AxelOrdi/Damier/DOC/7127br5-NyL._AC_SL1500_.jpg

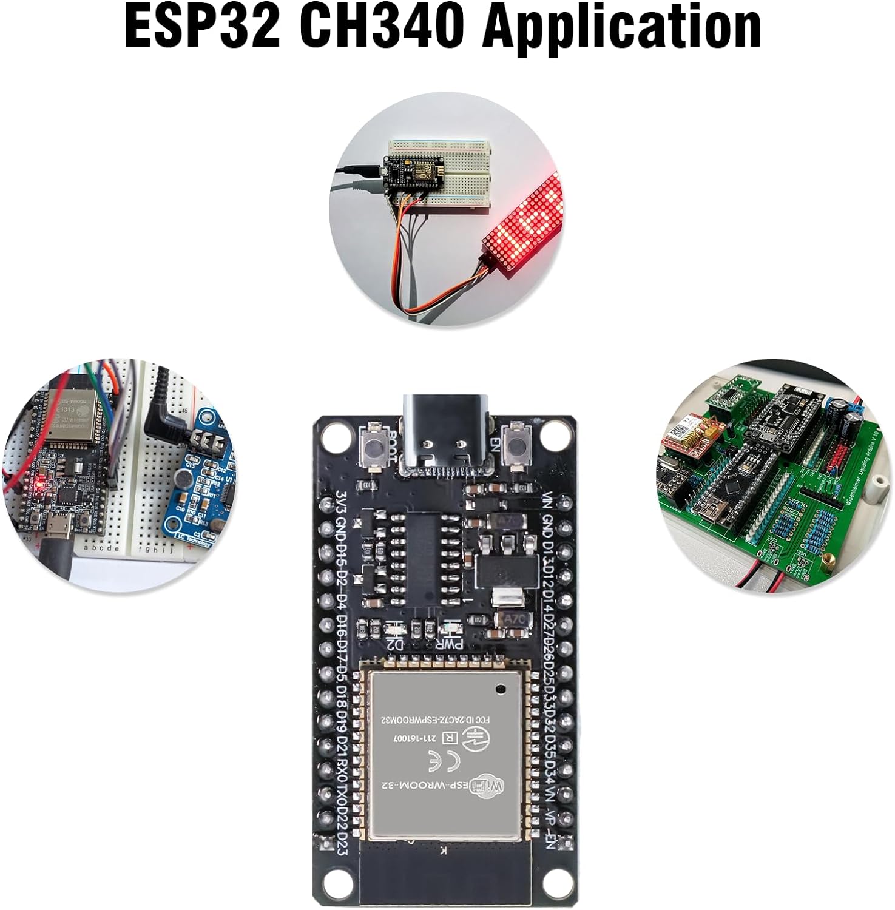
DOC/7127br5-NyL._AC_SL1500_.jpg
