AxelOrdi/Damier/Compte Rendu/CR/Diagramme de classe damier.drawio.pdf

Pion

- uint32_t couleur_led
- bool Reine
- bool PionBlanc

+ Pion()

+void setReine();

+bool getReine();

+uint32_t get_Couleur_led()

+void set_Couleur_led(uint32_t)

+void set_PionBlanc(bool pb)

+bool get_PionBlanc()

Pion_Blanc

+static int NbPionBlanc

Pion_Noir

+static int NbPionNoir

| Plateau
- Case Tableau[][] + void Initialisation_tableau() +void Commencer_Partie() + void Set_Couleur_Tableau_sans_Pion()

+ Case get_CasePlateau(int ligne,int colonne)

Case

- uint32_t couleur_led
- bool pion_sur_case
- bool case_blanche
- int num_case_strip
- int colonne
- int ligne
- Pion* Case

+ Case()

+ Case(uint32_t c , bool etat)

+ uint32_t get_couleur_led()

+ void set_couleur_led(Adafruit_NeoPixel STRIP_LED, uint32_t couleur_led)

+ bool get_pion_sur_case()

+ void set_pion_sur_case(bool b)

+ bool get_case_blanche()

+ void set_case_blanche(bool b)

+ void set_ligne(int ligne)

+ int get_ligne()

+ void set_colonne(int colonne)

+ int get_colonne()

+ void set_coordonnees(int ligne, int colonne)

+ vector<int> get_coordonnees()

+ Pion* get_Pion_case()

+ void set_Pion_case(Pion* p)

+ void Change_Couleur_Fct_Pion()

1

100

0..1 | 1

Jeu_de_Dame

//- Plateau Plateau_Jeu

- bool tour

+ Jeu_de_Dame()

+ void Initialisation_Pion()

+ void Commencer_Partie_Jeu_De_Dame ()

+ int Deplacer_Pion(std :: vector<int> Vecteur_Coordonnee_Initiale, std :: vector<int> Vecteur_Coordonnee_Finale)

+ int Verif_Deplacement_Possible(bool couleurTour, int ligneDepart, int colonneDepart, int ligneArrivee, int colonneArrivee)

+ int Manger_Pion(int Ligne_Position_Initiale,int Colonne_Position_initiale,int Ligne_Position_Finale,int Colonne_Position_Finale)

+ int Verif_Deplacement_Manger_Pion(int Ligne_Position,int Colonne_Position)

+ void Deroulement_Tour()

+ int Verif_Couleur_Pion(std ::vector<int> Vecteur_Coordonnee_Initiale)

+ int Etat_Attente_1(std::vector <int> &Vecteur_Coordonnee_Initiale)

+ int Etat_Attente_2(std ::vector<int> &Vecteur_Coordonnee_Initiale)

+ void Fin_de_jeu();

1

1
