AxelOrdi/Damier/3D/Paint_Damier.png

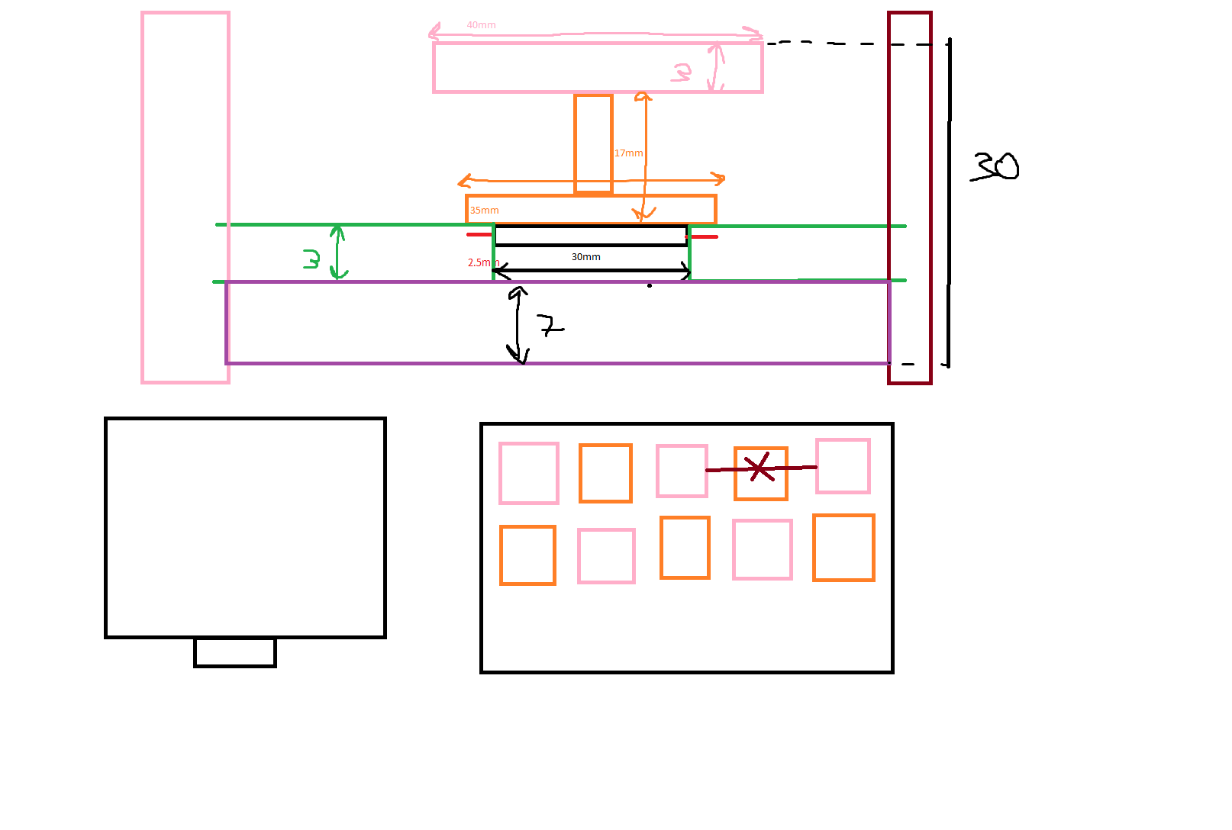
3D/Paint_Damier.png
