AxelOrdi/Damier/DOC/ESP32-DOIT-DEVKIT-V1-Board-Pinout-30-GPIOs-Copy.png

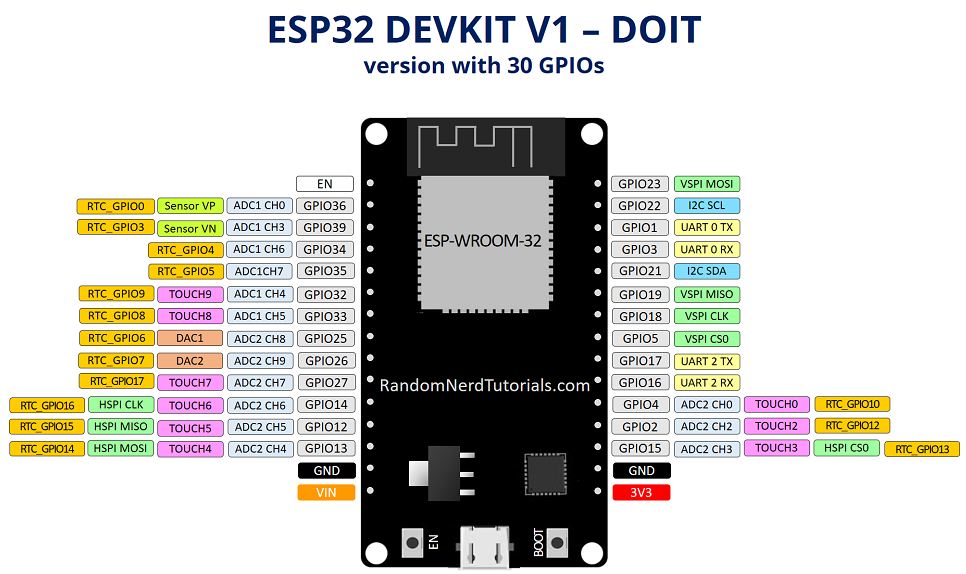
DOC/ESP32-DOIT-DEVKIT-V1-Board-Pinout-30-GPIOs-Copy.png
