AxelOrdi/Damier/3D/box_back.dxf

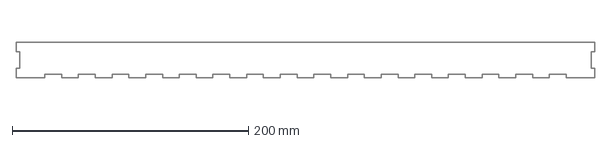
[picture p8: CAD file, 2023-12-12]
3D/box_back.dxf
490.0 x 30.0 mm
