AxelOrdi/Damier/3D/box_right.dxf

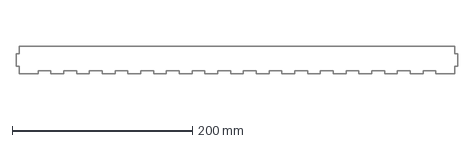
[picture p9: CAD file, 2023-12-12]
3D/box_right.dxf
490.0 x 30.0 mm
