AxelOrdi/Damier/3D/box_left.dxf

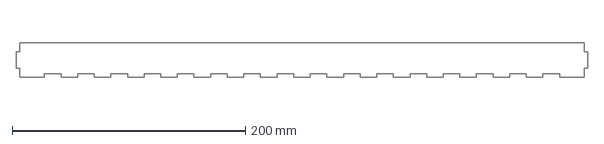
[picture p10: CAD file, 2023-12-12]
3D/box_left.dxf
490.0 x 30.0 mm
