AxelOrdi/Damier/3D/box_bottom.dxf

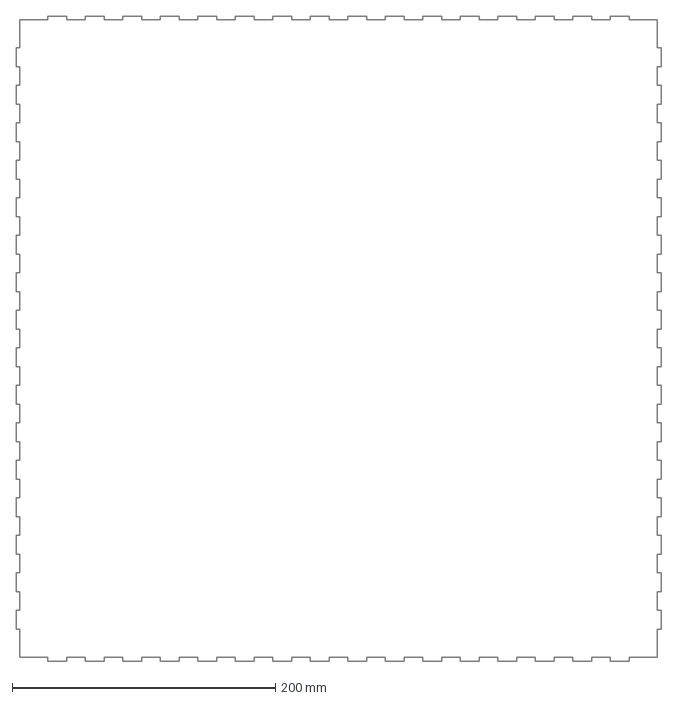
[picture p11: CAD file, 2023-12-12]
3D/box_bottom.dxf
490.0 x 490.0 mm
