AxelOrdi/Damier/3D/box_front.dxf

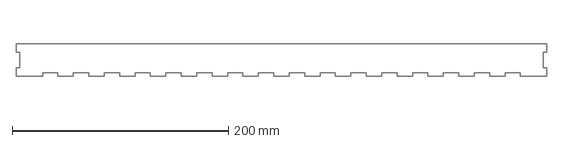
[picture p12: CAD file, 2023-12-12]
3D/box_front.dxf
490.0 x 30.0 mm
