AxelOrdi/Damier/PCB SLAVE/Le_damier.kicad_pcb

## KiCad design PCB SLAVE/Le_damier.kicad_pcb (2023-12-12)

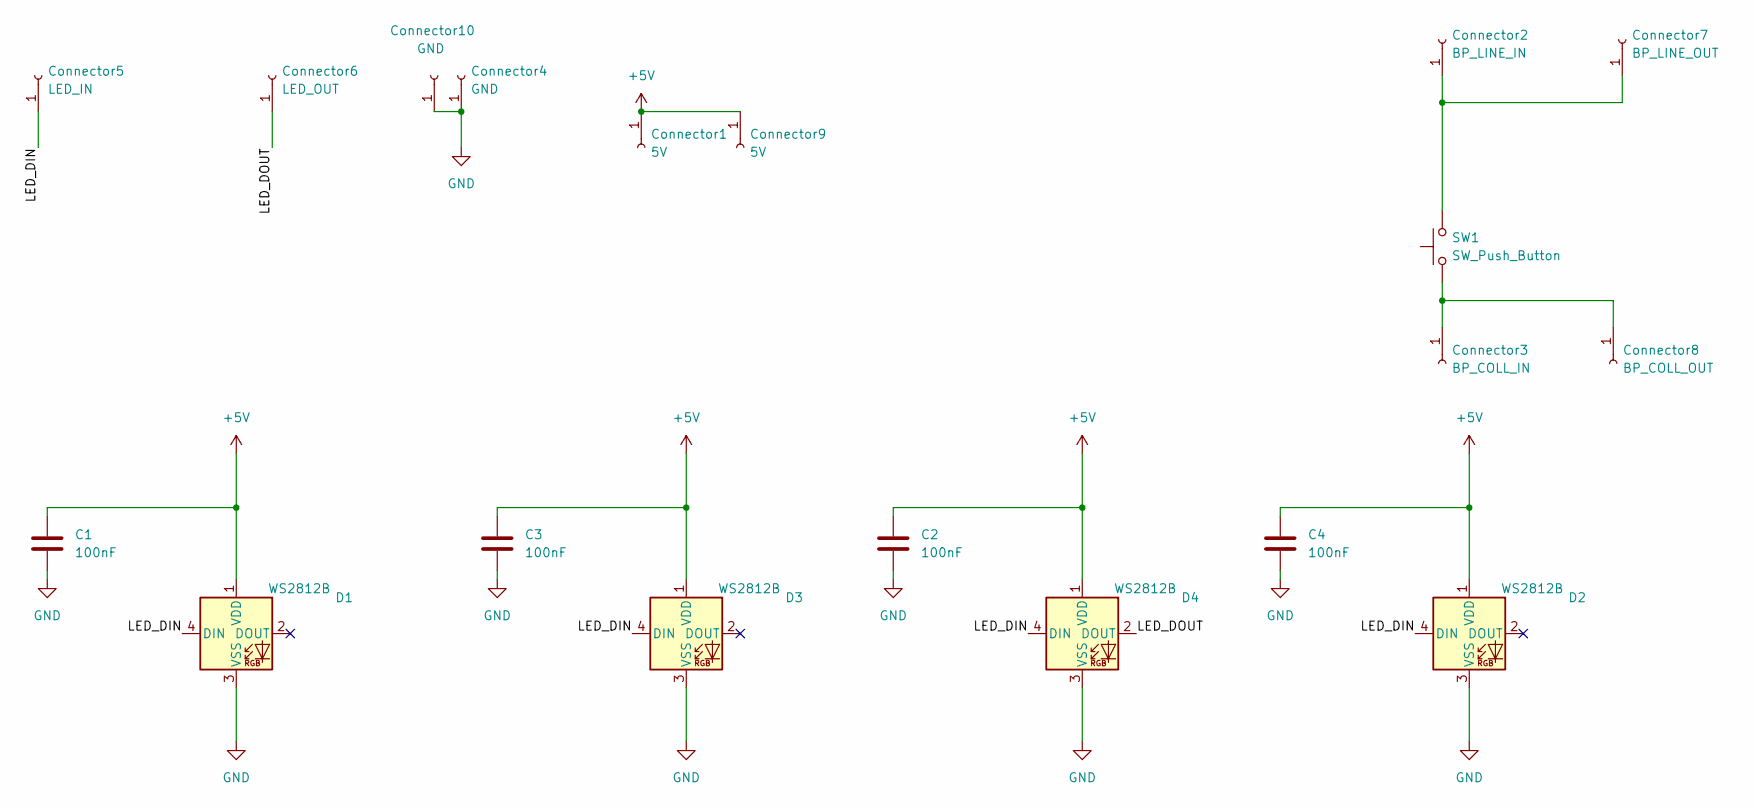
[picture p13: schematic Le_damier.kicad_sch]

Parts:
C1, C2, C3, C4: 100nF; C_1206_3216Metric
Connector1, Connector9: 5V; PinHeader_1x01_P2.54mm_Vertical
Connector2: BP_LINE_IN; PinHeader_1x01_P2.54mm_Vertical
Connector3: BP_COLL_IN; PinHeader_1x01_P2.54mm_Vertical
Connector4, Connector10: GND; PinHeader_1x01_P2.54mm_Vertical
Connector5: LED_IN; PinHeader_1x01_P2.54mm_Vertical
Connector6: LED_OUT; PinHeader_1x01_P2.54mm_Vertical
Connector7: BP_LINE_OUT; PinHeader_1x01_P2.54mm_Vertical
Connector8: BP_COLL_OUT; PinHeader_1x01_P2.54mm_Vertical
D1, D2, D3, D4: WS2812B; LED_WS2812B_PLCC4_5.0x5.0mm_P3.2mm
SW1: SW_Push_Button; SW_PUSH_6mm

Connections:
+5V: C1.1, C2.1, C3.1, C4.1, Connector1.1, Connector9.1, D1.1 (VDD), D2.1 (VDD), D3.1 (VDD), D4.1 (VDD)
/LED_DIN: Connector5.1, D1.4 (DIN), D2.4 (DIN), D3.4 (DIN), D4.4 (DIN)
/LED_DOUT: Connector6.1, D4.2 (DOUT)
GND: C1.2, C2.2, C3.2, C4.2, Connector4.1, Connector10.1, D1.3 (VSS), D2.3 (VSS), D3.3 (VSS), D4.3 (VSS)
unnamed: Connector2.1, Connector7.1, SW1.2
unnamed: Connector3.1, Connector8.1, SW1.1

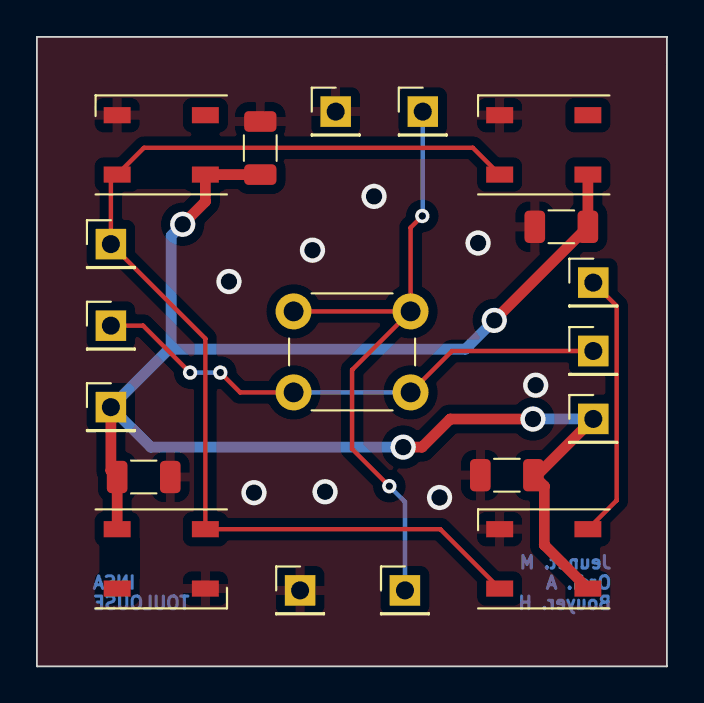
[picture p14: board Le_damier.kicad_pcb from above]

Board: 2 copper layers, 35.0 x 35.0 mm, 19 parts (0 on the bottom side), 6 nets.
