AxelOrdi/Damier/PCB MAITRE/MAIN v2/MAIN.kicad_pcb

## KiCad design PCB MAITRE/MAIN v2/MAIN.kicad_pcb (2023-12-12)

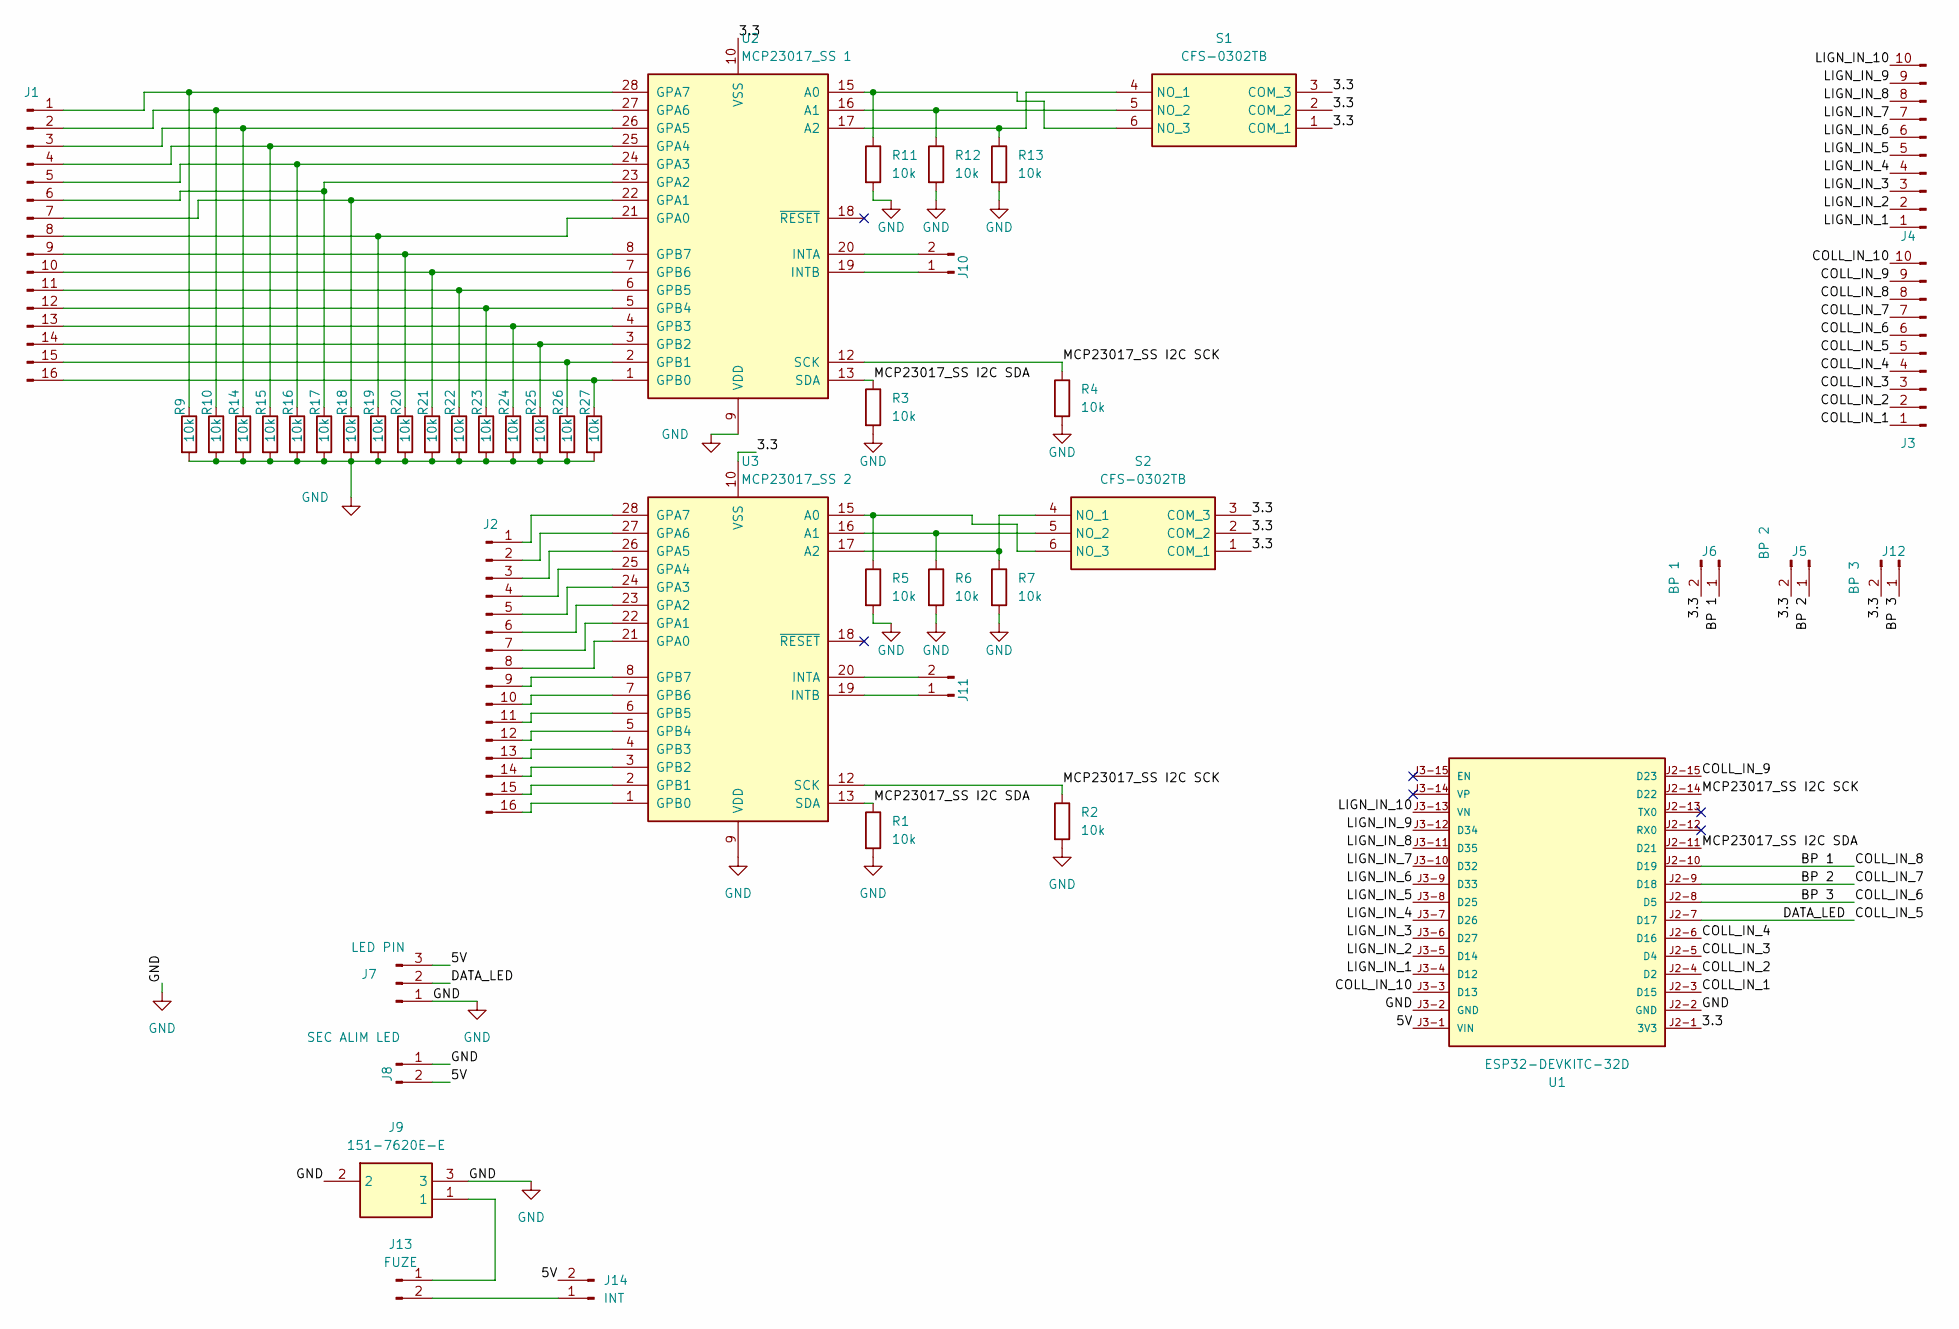
[picture p15: schematic MAIN.kicad_sch]

Parts:
J1, J2: Conn_01x16_Pin; PinHeader_1x16_P2.54mm_Vertical
J3, J4: Conn_01x10_Pin; PinHeader_1x10_P2.54mm_Vertical
J5: BP 2; PinHeader_1x02_P2.54mm_Vertical
J6: BP 1; PinHeader_1x02_P2.54mm_Vertical
J7: LED PIN; SolderWire-2.5sqmm_1x03_P8.8mm_D2.4mm_OD4.4mm
J8: SEC ALIM LED; SolderWire-2.5sqmm_1x02_P8.8mm_D2.4mm_OD4.4mm
J9: 151-7620E-E; 1517620EE; Mouser Part Number 151-7620E-E
J10: INTAB MCP23017 1; PinHeader_1x02_P2.54mm_Vertical
J11: INTAB MCP23017 2; PinHeader_1x02_P2.54mm_Vertical
J12: BP 3; PinHeader_1x02_P2.54mm_Vertical
J13: FUZE; SolderWire-2.5sqmm_1x02_P8.8mm_D2.4mm_OD4.4mm
J14: INT; SolderWire-2.5sqmm_1x02_P8.8mm_D2.4mm_OD4.4mm
R1, R2, R3, R4, R5, R6, R7, R9, R10, R11, R12, R13, R14, R15, R16, R17, R18, R19, R20, R21, R22, R23, R24, R25, R26, R27: 10k; R_1206_3216Metric
S1, S2: CFS-0302TB; CFS0302TB; Mouser Part Number 229-CFS-0302TB
U1: ESP32-DEVKITC-32D; MODULE_ESP32-DEVKITC-32D; PARTREV V4
U2: MCP23017_SS 1; SSOP-28_5.3x10.2mm_P0.65mm
U3: MCP23017_SS 2; SSOP-28_5.3x10.2mm_P0.65mm

Connections:
/3.3: J5.2, J6.2, J12.2, S1.1 (COM_1), S1.2 (COM_2), S1.3 (COM_3), S2.1 (COM_1), S2.2 (COM_2), S2.3 (COM_3), U1.J2-1 (3V3), U2.10 (VSS), U3.10 (VSS)
/5V: J7.3, J8.2, J14.2, U1.J3-1 (VIN)
/BP 1: J3.8, J6.1, U1.J2-10 (D19)
/BP 2: J3.7, J5.1, U1.J2-9 (D18)
/BP 3: J3.6, J12.1, U1.J2-8 (D5)
/COLL_IN_1: J3.1, U1.J2-3 (D15)
/COLL_IN_2: J3.2, U1.J2-4 (D2)
/COLL_IN_3: J3.3, U1.J2-5 (D4)
/COLL_IN_4: J3.4, U1.J2-6 (D16)
/COLL_IN_5: J3.5, J7.2, U1.J2-7 (D17)
/COLL_IN_9: J3.9, U1.J2-15 (D23)
/COLL_IN_10: J3.10, U1.J3-3 (D13)
/LIGN_IN_1: J4.1, U1.J3-4 (D12)
/LIGN_IN_2: J4.2, U1.J3-5 (D14)
/LIGN_IN_3: J4.3, U1.J3-6 (D27)
/LIGN_IN_4: J4.4, U1.J3-7 (D26)
/LIGN_IN_5: J4.5, U1.J3-8 (D25)
/LIGN_IN_6: J4.6, U1.J3-9 (D33)
/LIGN_IN_7: J4.7, U1.J3-10 (D32)
/LIGN_IN_8: J4.8, U1.J3-11 (D35)
/LIGN_IN_9: J4.9, U1.J3-12 (D34)
/LIGN_IN_10: J4.10, U1.J3-13 (VN)
/MCP23017_SS I2C SCK: R2.1, R4.1, U1.J2-14 (D22), U2.12 (SCK), U3.12 (SCK)
/MCP23017_SS I2C SDA: R1.1, R3.1, U1.J2-11 (D21), U2.13 (SDA), U3.13 (SDA)
GND: J7.1, J8.1, J9.2, J9.3, R1.2, R2.2, R3.2, R4.2, R5.2, R6.2, R7.2, R9.2, R10.2, R11.2, R12.2, R13.2, R14.2, R15.2, R16.2, R17.2, R18.2, R19.2, R20.2, R21.2, R22.2, R23.2, R24.2, R25.2, R26.2, R27.2, U1.J2-2 (GND), U1.J3-2 (GND), U2.9 (VDD), U3.9 (VDD)
unnamed: J1.1, R9.1, U2.28 (GPA7)
unnamed: J1.2, R10.1, U2.27 (GPA6)
unnamed: J1.3, R14.1, U2.26 (GPA5)
unnamed: J1.4, R15.1, U2.25 (GPA4)
unnamed: J1.5, R16.1, U2.24 (GPA3)
unnamed: J1.6, R17.1, U2.23 (GPA2)
unnamed: J1.7, R18.1, U2.22 (GPA1)
unnamed: J1.8, R19.1, U2.21 (GPA0)
unnamed: J1.9, R20.1, U2.8 (GPB7)
unnamed: J1.10, R21.1, U2.7 (GPB6)
unnamed: J1.11, R22.1, U2.6 (GPB5)
unnamed: J1.12, R23.1, U2.5 (GPB4)
unnamed: J1.13, R24.1, U2.4 (GPB3)
unnamed: J1.14, R25.1, U2.3 (GPB2)
unnamed: J1.15, R26.1, U2.2 (GPB1)
unnamed: J1.16, R27.1, U2.1 (GPB0)
unnamed: J2.1, U3.28 (GPA7)
unnamed: J2.2, U3.27 (GPA6)
unnamed: J2.3, U3.26 (GPA5)
unnamed: J2.4, U3.25 (GPA4)
unnamed: J2.5, U3.24 (GPA3)
unnamed: J2.6, U3.23 (GPA2)
unnamed: J2.7, U3.22 (GPA1)
unnamed: J2.8, U3.21 (GPA0)
unnamed: J2.9, U3.8 (GPB7)
unnamed: J2.10, U3.7 (GPB6)
unnamed: J2.11, U3.6 (GPB5)
unnamed: J2.12, U3.5 (GPB4)
unnamed: J2.13, U3.4 (GPB3)
unnamed: J2.14, U3.3 (GPB2)
unnamed: J2.15, U3.2 (GPB1)
unnamed: J2.16, U3.1 (GPB0)
unnamed: J10.1, U2.19 (INTB)
unnamed: J10.2, U2.20 (INTA)
unnamed: J11.1, U3.19 (INTB)
unnamed: J11.2, U3.20 (INTA)
unnamed: J9.1, J13.1
unnamed: J13.2, J14.1
unnamed: R13.1, S1.4 (NO_1), U2.17 (A2)
unnamed: R12.1, S1.5 (NO_2), U2.16 (A1)
unnamed: R11.1, S1.6 (NO_3), U2.15 (A0)
unnamed: R7.1, S2.4 (NO_1), U3.17 (A2)
unnamed: R6.1, S2.5 (NO_2), U3.16 (A1)
unnamed: R5.1, S2.6 (NO_3), U3.15 (A0)

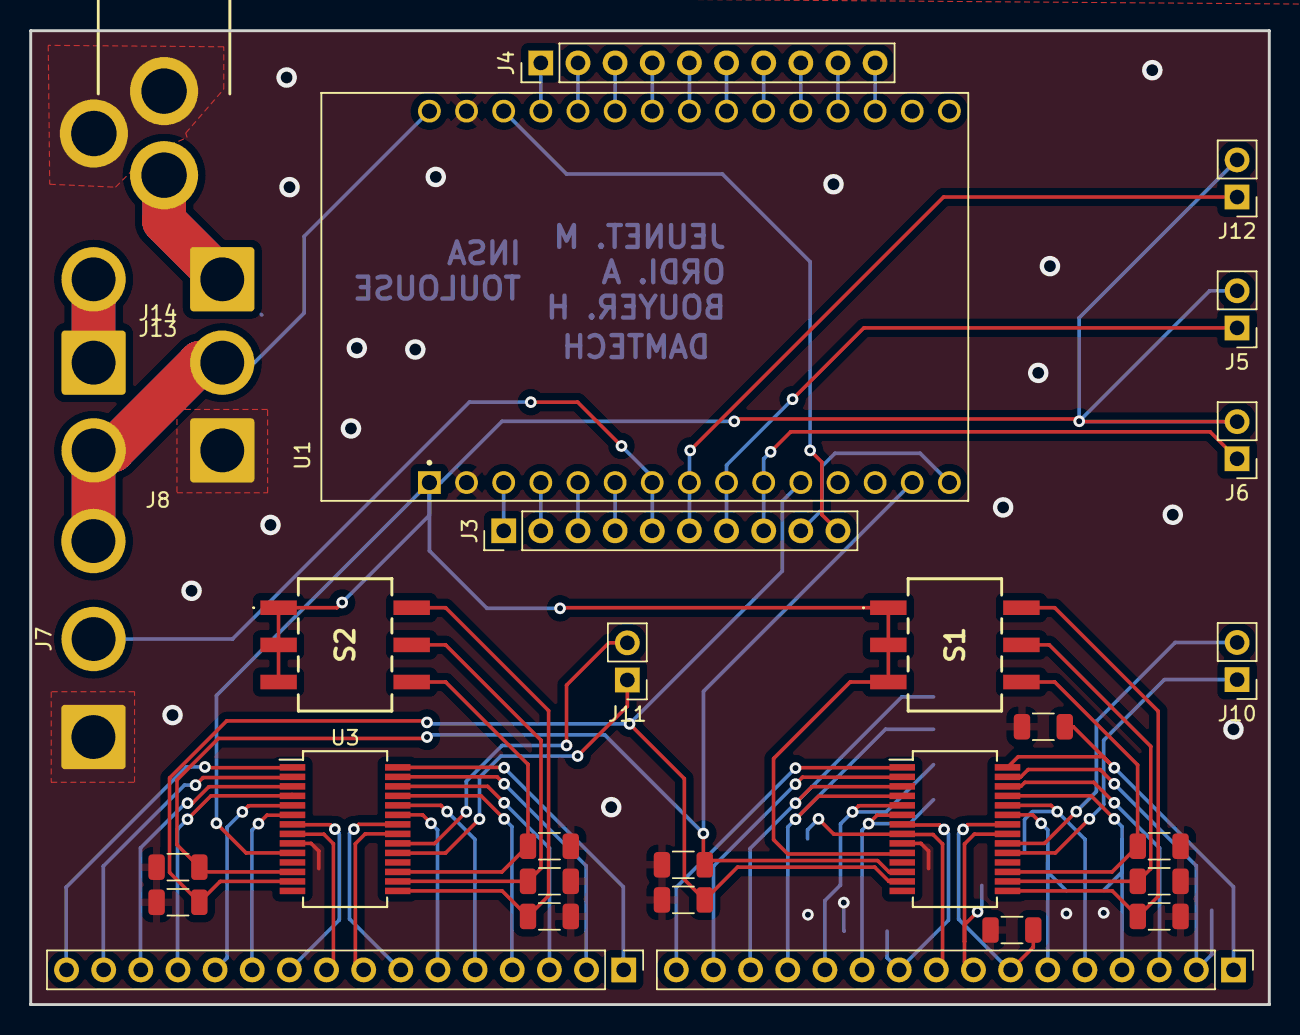
[picture p16: board MAIN.kicad_pcb from above]

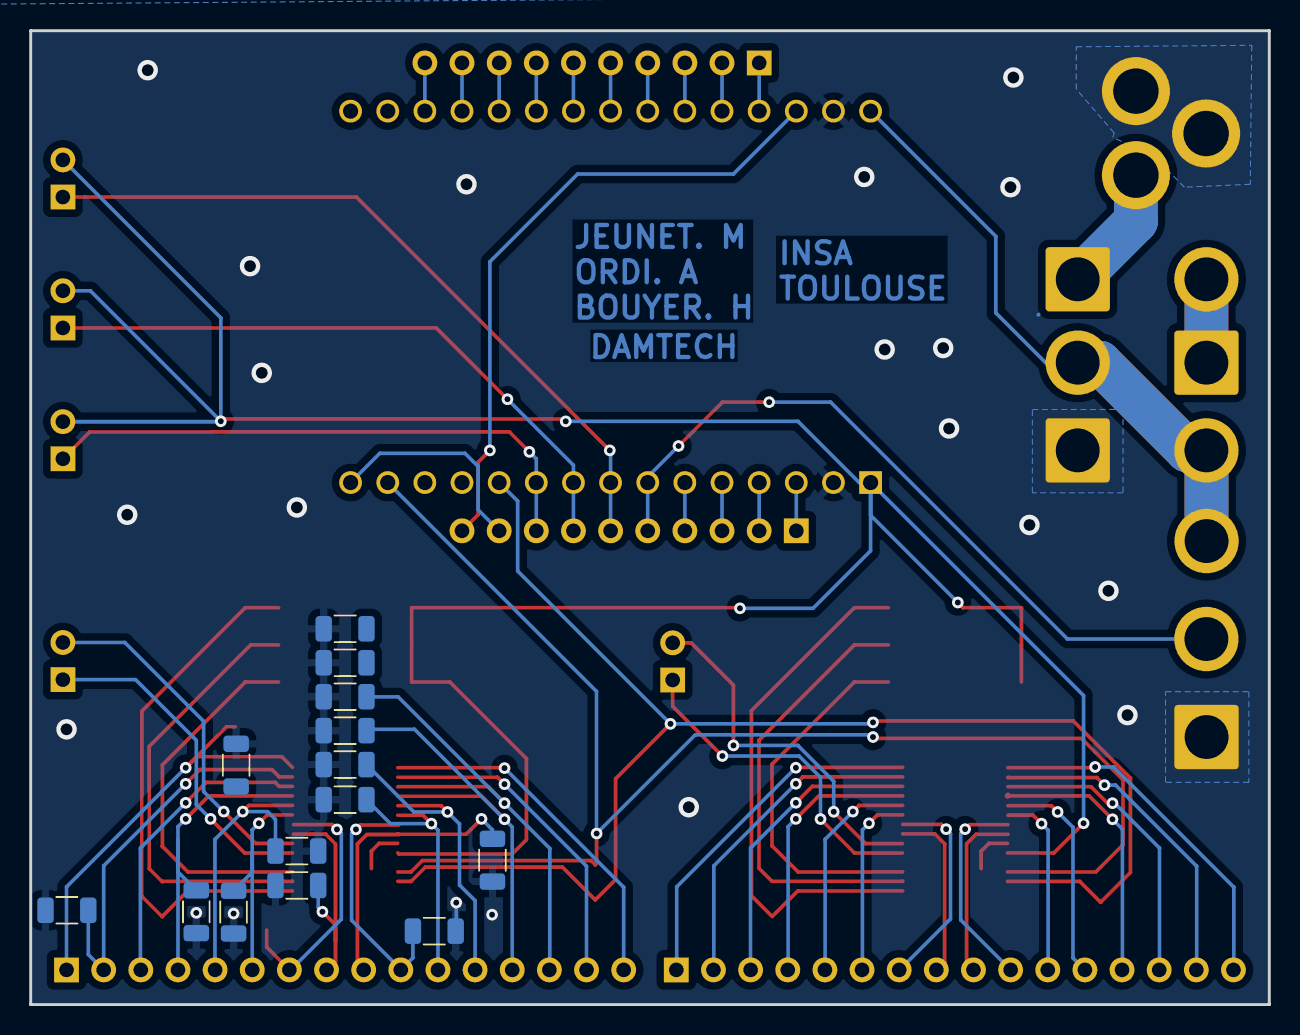
[picture p17: board MAIN.kicad_pcb from below]

Board: 2 copper layers, 84.7 x 66.6 mm, 45 parts (14 on the bottom side), 69 nets.
