AxelOrdi/Damier/Code/Librairies/Dames/Pion_Blanc.h

#ifndef _PION_BLANC_H_
#define _PION_BLANC_H_

#include <Pion.h>
#include <define.h>
#include <cstdint>

class Pion_Blanc : public Pion
{
private:
    
public:
    static int NbPionBlanc;
    Pion_Blanc();
    ~Pion_Blanc();
};



#endif
