AxelOrdi/Damier/(commit log)

2023-12-13 changer la position des pions créer dans Jeu de Dame pour la condition de fin de jeu
2023-12-15 Changement des coordonnées dans jeu_de_dame Etat 7. +Il est peut etre nécessaire de vérifier si cet état doit rammener a etat 6 ou 3
